danpeig/ESP32EnergyMonitor/images/home_assistant_integration.png

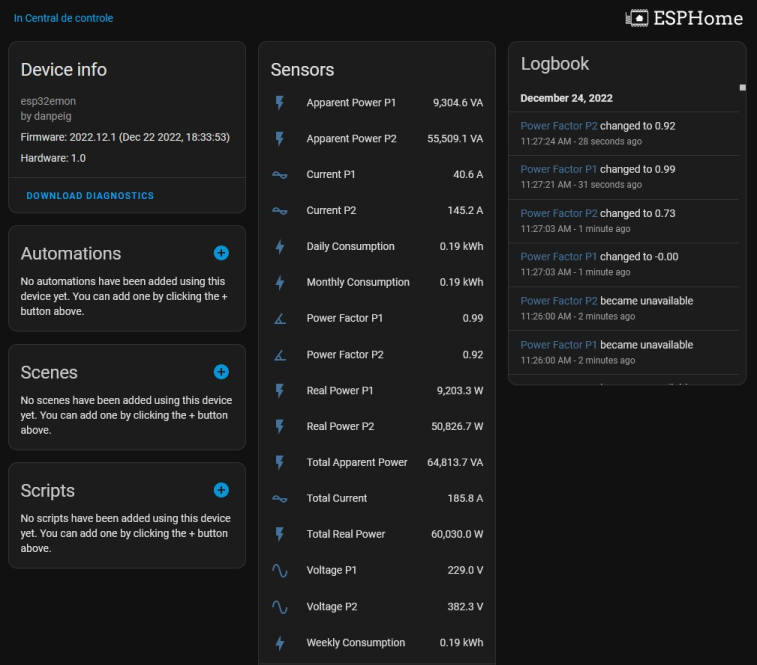
images/home_assistant_integration.png
