danpeig/ESP32EnergyMonitor/images/potenciometro-calibrado.jpg

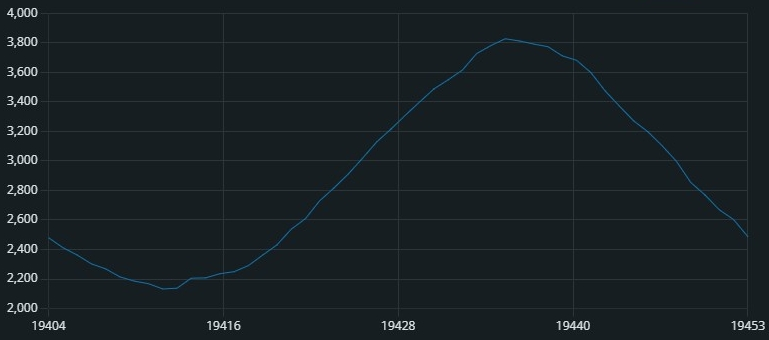
images/potenciometro-calibrado.jpg
