danpeig/ESP32EnergyMonitor/images/potenciometro-descalibrado.png

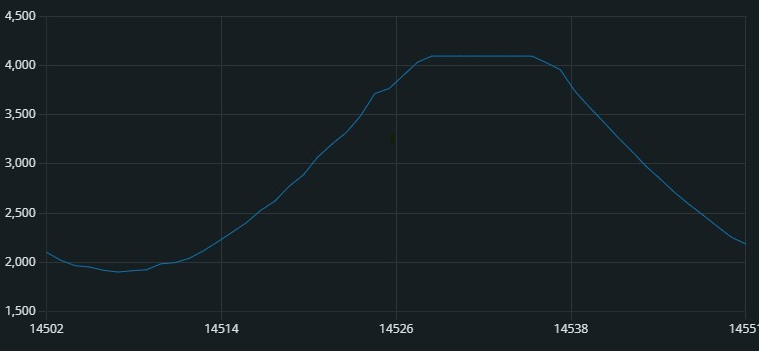
images/potenciometro-descalibrado.png
