danpeig/ESP32EnergyMonitor/(threads)

Thread 1 (2023-03-17):

Using without voltage meter?

fitim7, 2023-03-17:
Hi, is it possible to use this without a voltage meter?

danpeig, 2023-04-07:
ESPHome already has current measurements "out-of-the-box", there is no need to use this software at all (https://esphome.io/components/sensor/ct_clamp.html).

Please be aware that without voltage measurement you lose the ability to measure power factor and the real power.

Closed 2023-04-07.

Thread 2 (2023-03-19):

It will not read the third phase. Real Power and Power Factor

vladakru, 2023-03-19:
Greetings, I am very pleased with the project you made.
I have a problem with reading Power Factor P3 and Real Power P3 is always 0.00, P1 and P2 print values   normally.
I must mention that Apparent Power P3 and Current P3 also print values   normally.
I am afraid that this affects the Total Real Power so that the Monthly and Daily Consumption are incorrect.
How could I solve this problem?
THX
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

danpeig, 2023-03-19:
Hi,

Did you tried inverting the direction of the current sensor for P3?

vladakru, 2023-03-19:
I didn't turn the sensor because during the calibration process it was in the same direction as it is now and it worked like that, so I suspected that it might not be a problem in the code...

vladakru, 2023-03-19:
how does the Curen P3 measure me and it won't count the Real Power P3...???

danpeig, 2023-03-19:
Can you run the calibration script again replacing this code block:
`
  Serial.print("V3: ");
  Serial.print(supplyVoltage3);
  Serial.print(", I3: ");
  Serial.println(Irms3);
`

with this

`
  Serial.print("V3: ");
  Serial.print(supplyVoltage3);
  Serial.print("PF3: ");
  Serial.print(powerFactor3);
  Serial.print(", I3: ");
  Serial.println(Irms3);
`

What we are looking for is a negative power factor.

vladakru, 2023-03-19:
with no load:
------------
V1: 229.00, I1: 0.92
V2: 225.42, I2: 0.88
V3: 226.79PF3: -0.02, I3: 1.02

with load:
V1: 221.39, I1: 13.11
V2: 218.49, I2: 13.28
V3: 220.35PF3: 0.85, I3: 12.92

danpeig, 2023-03-19:
The hardware appears to be working well. 3 positive parameters.
Now we must check ESPHome and Home Assistant.
When you run the ESPHome console/terminal, do you get similar results in the output variables (voltage, current, and PF)?

vladakru, 2023-03-19:
This is report from pc terminal directly connected to ESP32
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

danpeig, 2023-03-19:
Ok, the problem is not in Home Assistant.

Would you mind sharing your _esp32emon.yaml_ and _esp32emon.h_ sources? You can change any sensitive information. I just want to compile and test here.

vladakru, 2023-03-20:
esp32emon.yaml
`# Platform settings
esphome:
  name: esp32emon
  name_add_mac_suffix: true
  includes:
    - emonlib/EmonLib.h
    - emonlib/EmonLib.cpp
    - esp32emon.h
  project:
    name: danpeig.esp32emon
    version: "1.3.0"

# Board configuration
esp32:
  board: esp32doit-devkit-v1
  framework:
    type: arduino

# Sets up Bluetooth LE (Only on ESP32) to allow the user
# to provision wifi credentials to the device.
esp32_improv:
  authorizer: none

# Sets up the improv via serial client for Wi-Fi provisioning
improv_serial:

# Enable logging
logger:

# Enable Home Assistant API
api:

# Enable OTA updates
ota:
  password: !secret ota_password

# Wifi configuration
wifi:
  networks:
    # Main network
   - ssid: !secret wifi_ssid
     password: !secret wifi_password
    # Alternative network
    # - ssid: !secret wifi_ssid2
      # password: !secret wifi_password2

  # Enable fallback hotspot (captive portal) in case wifi connection fails
  # ap:
    # ssid: "Esp32EnergyMeter"
    # password: !secret wifi_ap_password

captive_portal:

# MQTT Integration
#mqtt:
#  broker: !secret mqtt_broker
#  port: !secret mqtt_port
#  username: !secret mqtt_user
#  password: !secret mqtt_password
#  discovery: false #We are using the default API for Home Assistant discovery, no need for MQTT

# Timers configuration
time:
  - platform: sntp
    id: sntp_time1
    on_time:
      # Every Month at specified day
      - seconds: 0
        minutes: 0
        hours: 0
        days_of_month: 1
        then:
          - sensor.integration.reset: total_energy_month #Reset power integrator
      # Every Week at specified day
      - seconds: 0
        minutes: 0
        hours: 0
        days_of_week: MON
        then:
          - sensor.integration.reset: total_energy_week #Reset power integrator
      # Every Day at specified hour
      - seconds: 0
        minutes: 0
        hours: 0
        then:
          - sensor.integration.reset: total_energy_day #Reset power integrator

sensor:
  #Custom sensors from EMon
  - platform: custom
    lambda: |-
      auto my_sensor = new MyPowerSensor();
      App.register_component(my_sensor);

      // 1-Phase - - uncomment only the following line for 1 phase measurements
      //return {my_sensor->realpower_sensor1, my_sensor->apparentpower_sensor1, my_sensor->powerfactor_sensor1, my_sensor->supplyvoltage_sensor1, my_sensor->current_sensor1, my_sensor->realpower_sensor_total, my_sensor->apparentpower_sensor_total, my_sensor->current_sensor_total};

      // 2-Phases - uncomment only the following line for 2 phase measurements
      //return {my_sensor->realpower_sensor1, my_sensor->apparentpower_sensor1, my_sensor->powerfactor_sensor1, my_sensor->supplyvoltage_sensor1, my_sensor->current_sensor1, my_sensor->realpower_sensor2, my_sensor->apparentpower_sensor2, my_sensor->powerfactor_sensor2, my_sensor->supplyvoltage_sensor2, my_sensor->current_sensor2, my_sensor->realpower_sensor_total, my_sensor->apparentpower_sensor_total, my_sensor->current_sensor_total};

      // 3-Phases - uncomment only the following line for 3 phase measurements
      return {my_sensor->realpower_sensor1, my_sensor->apparentpower_sensor1, my_sensor->powerfactor_sensor1, my_sensor->supplyvoltage_sensor1, my_sensor->current_sensor1, my_sensor->realpower_sensor2, my_sensor->apparentpower_sensor2, my_sensor->powerfactor_sensor2, my_sensor->supplyvoltage_sensor2, my_sensor->current_sensor2, my_sensor->realpower_sensor3, my_sensor->apparentpower_sensor3, my_sensor->powerfactor_sensor3, my_sensor->supplyvoltage_sensor3, my_sensor->current_sensor3, my_sensor->realpower_sensor_total, my_sensor->apparentpower_sensor_total, my_sensor->current_sensor_total};
    sensors:
      #Phase 1 sensors
      - name: "Real Power P1"
        device_class: "power"
        unit_of_measurement: W
        state_class: "measurement"
        accuracy_decimals: 1
        internal: false
        filters:
          - lambda: |-
              //Avoid corrupting integration sensors
              if(!isinf(x) && !isnan(x) && x >= 0 && x <= 10e6)
                {
                return x;
                }
              else
                {
                return 0;
                }
      - name: "Apparent Power P1"
        device_class: "apparent_power"
        unit_of_measurement: VA
        state_class: "measurement"
        accuracy_decimals: 1
        internal: false
        filters:
          - lambda: |-
              //Avoid corrupting integration sensors
              if(!isinf(x) && !isnan(x) && x >= 0 && x <= 10e6)
                {
                return x;
                }
              else
                {
                return 0;
                }
      - name: "Power Factor P1"
        device_class: "power_factor"
        state_class: "measurement"
        accuracy_decimals: 2
        internal: false
        filters:
          - lambda: |-
              //Avoid corrupting integration sensors
              if(!isinf(x) && !isnan(x) && x >= 0 && x <= 10e6)
                {
                return x;
                }
              else
                {
                return 0;
                }
      - name: "Voltage P1"
        device_class: "voltage"
        unit_of_measurement: V
        accuracy_decimals: 1
        internal: false
        filters:
          - lambda: |-
              //Avoid corrupting integration sensors
              if(!isinf(x) && !isnan(x) && x >= 0 && x <= 10e6)
                {
                return x;
                }
              else
                {
                return 0;
                }
      - name: "Current P1"
        device_class: "current"
        unit_of_measurement: A
        accuracy_decimals: 1
        internal: false
        filters:
          - lambda: |-
              //Avoid corrupting integration sensors
              if(!isinf(x) && !isnan(x) && x >= 0 && x <= 10e6)
                {
                return x;
                }
              else
                {
                return 0;
                }

        #Phase 2 sensors
      - name: "Real Power P2"
        device_class: "power"
        unit_of_measurement: W
        state_class: "measurement"
        accuracy_decimals: 1
        internal: false
        filters:
          - lambda: |-
              //Avoid corrupting integration sensors
              if(!isinf(x) && !isnan(x) && x >= 0 && x <= 10e6)
                {
                return x;
                }
              else
                {
                return 0;
                }
      - name: "Apparent Power P2"
        device_class: "apparent_power"
        unit_of_measurement: VA
        state_class: "measurement"
        accuracy_decimals: 1
        internal: false
        filters:
          - lambda: |-
              //Avoid corrupting integration sensors
              if(!isinf(x) && !isnan(x) && x >= 0 && x <= 10e6)
                {
                return x;
                }
              else
                {
                return 0;
                }
      - name: "Power Factor P2"
        device_class: "power_factor"
        state_class: "measurement"
        accuracy_decimals: 2
        internal: false
        filters:
          - lambda: |-
              //Avoid corrupting integration sensors
              if(!isinf(x) && !isnan(x) && x >= 0 && x <= 10e6)
                {
                return x;
                }
              else
                {
                return 0;
                }
      - name: "Voltage P2"
        device_class: "voltage"
        unit_of_measurement: V
        accuracy_decimals: 1
        internal: false
        filters:
          - lambda: |-
              //Avoid corrupting integration sensors
              if(!isinf(x) && !isnan(x) && x >= 0 && x <= 10e6)
                {
                return x;
                }
              else
                {
                return 0;
                }
      - name: "Current P2"
        device_class: "current"
        unit_of_measurement: A
        accuracy_decimals: 1
        internal: false
        filters:
          - lambda: |-
              //Avoid corrupting integration sensors
              if(!isinf(x) && !isnan(x) && x >= 0 && x <= 10e6)
                {
                return x;
                }
              else
                {
                return 0;
                }

        #Phase 3 sensors
      - name: "Real Power P3"
        device_class: "power"
        unit_of_measurement: W
        state_class: "measurement"
        accuracy_decimals: 1
        internal: false
        filters:
          - lambda: |-
              //Avoid corrupting integration sensors
              if(!isinf(x) && !isnan(x) && x >= 0 && x <= 10e6)
                {
                return x;
                }
              else
                {
                return 0;
                }
      - name: "Apparent Power P3"
        device_class: "apparent_power"
        unit_of_measurement: VA
        state_class: "measurement"
        accuracy_decimals: 1
        internal: false
        filters:
          - lambda: |-
              //Avoid corrupting integration sensors
              if(!isinf(x) && !isnan(x) && x >= 0 && x <= 10e6)
                {
                return x;
                }
              else
                {
                return 0;
                }
      - name: "Power Factor P3"
        device_class: "power_factor"
        state_class: "measurement"
        accuracy_decimals: 2
        internal: false
        filters:
          - lambda: |-
              //Avoid corrupting integration sensors
              if(!isinf(x) && !isnan(x) && x >= 0 && x <= 10e6)
                {
                return x;
                }
              else
                {
                return 0;
                }
      - name: "Voltage P3"
        device_class: "voltage"
        unit_of_measurement: V
        accuracy_decimals: 1
        internal: false
        filters:
          - lambda: |-
              //Avoid corrupting integration sensors
              if(!isinf(x) && !isnan(x) && x >= 0 && x <= 10e6)
                {
                return x;
                }
              else
                {
                return 0;
                }
      - name: "Current P3"
        device_class: "current"
        unit_of_measurement: A
        accuracy_decimals: 1
        internal: false
        filters:
          - lambda: |-
              //Avoid corrupting integration sensors
              if(!isinf(x) && !isnan(x) && x >= 0 && x <= 10e6)
                {
                return x;
                }
              else
                {
                return 0;
                }

      #Total sensors
      - name: "Total Real Power"
        id: "real_power_sensor_total"
        device_class: "power"
        state_class: "measurement"
        unit_of_measurement: W
        accuracy_decimals: 1
        internal: false
        filters:
          - lambda: |-
              //Avoid corrupting integration sensors
              if(!isinf(x) && !isnan(x) && x >= 0 && x <= 10e6)
                {
                return x;
                }
              else
                {
                return 0;
                }
      - name: "Total Apparent Power"
        device_class: "apparent_power"
        state_class: "measurement"
        unit_of_measurement: VA
        accuracy_decimals: 1
        internal: false
        filters:
          - lambda: |-
              //Avoid corrupting integration sensors
              if(!isinf(x) && !isnan(x) && x >= 0 && x <= 10e6)
                {
                return x;
                }
              else
                {
                return 0;
                }
      - name: "Total Current"
        device_class: "current"
        state_class: "measurement"
        unit_of_measurement: A
        accuracy_decimals: 1
        internal: false
        filters:
          - lambda: |-
              //Avoid corrupting integration sensors
              if(!isinf(x) && !isnan(x) && x >= 0 && x <= 10e6)
                {
                return x;
                }
              else
                {
                return 0;
                }

  - platform: integration
    name: "Daily Consumption"
    id: "total_energy_day"
    sensor: real_power_sensor_total
    time_unit: h
    device_class: "energy"
    state_class: "total_increasing"
    unit_of_measurement: kWh
    accuracy_decimals: 2
    restore: false #If true, save the reading to the flash memory to prevent data loss in case of power loss
    filters:
      - multiply: 0.001

  - platform: integration
    name: "Weekly Consumption"
    id: "total_energy_week"
    sensor: real_power_sensor_total
    time_unit: h
    device_class: "energy"
    state_class: "total_increasing"
    unit_of_measurement: kWh
    accuracy_decimals: 2
    restore: false #If true, save the reading to the flash memory to prevent data loss in case of power loss
    filters:
      - multiply: 0.001

  - platform: integration
    name: "Monthly Consumption"
    id: "total_energy_month"
    sensor: real_power_sensor_total
    time_unit: h
    device_class: "energy"
    state_class: "total_increasing"
    unit_of_measurement: kWh
    accuracy_decimals: 2
    restore: false #If true, save the reading to the flash memory to prevent data loss in case of power loss
    filters:
      - multiply: 0.001

  # Wifi signal sensors
  - platform: wifi_signal # Reports the WiFi signal strength/RSSI in dB
    name: "WiFi signal dB"
    id: wifi_signal_db
    update_interval: 60s
    entity_category: "diagnostic"

  - platform: copy # Reports the WiFi signal strength in %
    source_id: wifi_signal_db
    name: "WiFi signal"
    filters:
      - lambda: return min(max(2 * (x + 100.0), 0.0), 100.0);
    unit_of_measurement: "%"
    entity_category: "diagnostic"

# Other information
text_sensor:
  - platform: wifi_info
    ip_address:
      name: ESP32 IP Address
    ssid:
      name: ESP32 SSID`

esp32emon.h
`#include "esphome.h"
#include "EmonLib.h"
#include "esp_task_wdt.h" //Watchdog control features
#define ESP32

// Watchdog timeout in seconds
#define WDT_TIMEOUT 5

// The Sample window length is defined by the number of half wavelengths or crossings we choose to measure.
// 120 is quite conservative for two phases
#define CROSSINGS 120

// Polling interval
#define POLLING_INTERVAL 30000 //Every 30s will perform a read and publish the data. Do not go under 5s to prevent crashes.

// Pin configuration
#define V1 34
#define V2 34 //Set to V1 if using only one voltage meter
#define V3 34 //Set to V1 if using only one voltage meter

#define I1 35
#define I2 32
#define I3 33

// Calibration for voltage sensors CV and current sensors CI
#define CV1 350.31
#define CV2 346.5 //Set to CV1 if using only one voltage meter
#define CV3 347.23 //Set to CV1 if using only one voltage meter

#define CI1 64.92
#define CI2 65.65
#define CI3 64.41

class MyPowerSensor : public PollingComponent, public Sensor
{
public:
  MyPowerSensor() : PollingComponent(POLLING_INTERVAL) {}

  float get_setup_priority() const override { return esphome::setup_priority::LATE; }

  EnergyMonitor emon1; // Phase 1
  EnergyMonitor emon2; // Phase 2
  EnergyMonitor emon3; // Phase 3

  // Phase 1 sensors
  Sensor *realpower_sensor1 = new Sensor();
  Sensor *apparentpower_sensor1 = new Sensor();
  Sensor *powerfactor_sensor1 = new Sensor();
  Sensor *supplyvoltage_sensor1 = new Sensor();
  Sensor *current_sensor1 = new Sensor();

  // Phase 2 sensors
  Sensor *realpower_sensor2 = new Sensor();
  Sensor *apparentpower_sensor2 = new Sensor();
  Sensor *powerfactor_sensor2 = new Sensor();
  Sensor *supplyvoltage_sensor2 = new Sensor();
  Sensor *current_sensor2 = new Sensor();

  // Phase 3 sensors
   Sensor *realpower_sensor3 = new Sensor();
   Sensor *apparentpower_sensor3 = new Sensor();
   Sensor *powerfactor_sensor3 = new Sensor();
   Sensor *supplyvoltage_sensor3 = new Sensor();
   Sensor *current_sensor3 = new Sensor();

  // Total sensors
  Sensor *realpower_sensor_total = new Sensor();
  Sensor *apparentpower_sensor_total = new Sensor();
  Sensor *current_sensor_total = new Sensor();

  void setup() override
  {

    esp_task_wdt_init(WDT_TIMEOUT, true); // enable panic so ESP32 restarts
    esp_task_wdt_add(NULL);               // add current thread to WDT watch

    /*
    Analog attenuation: When using 0-1V sensors the attenuation should be decreased to improve accuracy.

    ADC_0db: sets no attenuation. ADC can measure up to approximately 800 mV (1V input = ADC reading of 1088).
    ADC_2_5db: The input voltage of ADC will be attenuated, extending the range of measurement to up to approx. 1100 mV. (1V input = ADC reading of 3722).
    ADC_6db: The input voltage of ADC will be attenuated, extending the range of measurement to up to approx. 1350 mV. (1V input = ADC reading of 3033).
    ADC_11db (default): The input voltage of ADC will be attenuated, extending the range of measurement to up to approx. 2600 mV. (1V input = ADC reading of 1575).

    */
    analogSetPinAttenuation(V1, ADC_11db);
    analogSetPinAttenuation(V2, ADC_11db);
    analogSetPinAttenuation(V3, ADC_11db);

    analogSetPinAttenuation(I1, ADC_11db);
    analogSetPinAttenuation(I2, ADC_11db);
    analogSetPinAttenuation(I3, ADC_11db);

    // Phase 1 sensors
    emon1.voltage(V1, CV1, 1.732); // Voltage: input pin, calibration, phase_shift
    emon1.current(I1, CI1);        // Current: input pin, calibration.

    // Phase 2 sensors
    emon2.voltage(V2, CV2, 1.732); // Voltage: input pin, calibration, phase_shift
    emon2.current(I2, CI2);        // Current: input pin, calibration.

    //Phase 3 sensors
    emon3.voltage(V3, CV3, 1.732);  // Voltage: input pin, calibration, phase_shift
    emon3.current(I3, CI3);       // Current: input pin, calibration.

  }

  void update() override
  {

    // Phase 1
    emon1.calcVI(CROSSINGS, 2000);
    float realPower1 = emon1.realPower;
    realpower_sensor1->publish_state(realPower1);
    float apparentPower1 = emon1.apparentPower;
    apparentpower_sensor1->publish_state(apparentPower1);
    float powerFactor1 = emon1.powerFactor;
    powerfactor_sensor1->publish_state(powerFactor1);
    float supplyVoltage1 = emon1.Vrms;
    supplyvoltage_sensor1->publish_state(supplyVoltage1);
    float current1 = emon1.Irms;
    current_sensor1->publish_state(current1);

    esp_task_wdt_reset(); // Things can take some time... this ensures the watchdog is aware

    // Phase 2
    emon2.calcVI(CROSSINGS, 2000);
    float realPower2 = emon2.realPower;
    realpower_sensor2->publish_state(realPower2);
    float apparentPower2 = emon2.apparentPower;
    apparentpower_sensor2->publish_state(apparentPower2);
    float powerFactor2 = emon2.powerFactor;
    powerfactor_sensor2->publish_state(powerFactor2);
    float supplyVoltage2 = emon2.Vrms;
    supplyvoltage_sensor2->publish_state(supplyVoltage2);
    float current2 = emon2.Irms;
    current_sensor2->publish_state(current2);

    esp_task_wdt_reset(); // Things can take some time... this ensures the watchdog is aware

     // Phase 3
     emon3.calcVI(CROSSINGS,2000);
     float realPower3 = emon3.realPower;
     realpower_sensor3->publish_state(realPower3);
     float apparentPower3 = emon3.apparentPower;
     apparentpower_sensor3->publish_state(apparentPower3);
     float powerFactor3 = emon3.powerFactor;
     powerfactor_sensor3->publish_state(powerFactor3);
     float supplyVoltage3 = emon3.Vrms;
     supplyvoltage_sensor3->publish_state(supplyVoltage3);
     float current3 = emon3.Irms;
     current_sensor3->publish_state(current3);

    /*
    // Totals 1 phase - uncomment only this block if you are reading one phase
    float realPower_total = emon1.realPower;
    realpower_sensor_total->publish_state(realPower_total);
    float apparentPower_total = emon1.apparentPower;
    apparentpower_sensor_total->publish_state(apparentPower_total);
    float current_total = emon1.Irms;
    current_sensor_total->publish_state(current_total);
    */

	/*
    // Totals 2 phases - uncomment only this block if you are reading two phases
    float realPower_total = emon1.realPower + emon2.realPower;
    realpower_sensor_total->publish_state(realPower_total);
    float apparentPower_total = emon1.apparentPower + emon2.apparentPower;
    apparentpower_sensor_total->publish_state(apparentPower_total);
    float current_total = emon1.Irms + emon2.Irms;
    current_sensor_total->publish_state(current_total);
	*/

     // Totals 3 phases - uncomment only this block if you are reading three phases
     float realPower_total = emon1.realPower + emon2.realPower + emon3.realPower;
     realpower_sensor_total->publish_state(realPower_total);
     float apparentPower_total = emon1.apparentPower + emon2.apparentPower + emon3.apparentPower;
     apparentpower_sensor_total->publish_state(apparentPower_total);
     float current_total = emon1.Irms + emon2.Irms + emon3.Irms;
     current_sensor_total->publish_state(current_total);

  }
};
`

vladakru, 2023-03-20:
thanks for your time, I'll try flashing again and see if it works.
thanks again

vladakru, 2023-03-20:
As you saw on the test table, everything worked as it should, when I connected it to the mains, one phase read amperes again, but not PF and RP, when I turned the CT sensor in the opposite direction, that phase worked with the readings. I don't know how it's like the current is flowing in the opposite direction or whatever... I hope that now with that setup the reading will be fine.

danpeig, 2023-03-26:
Here is the explanation from OpenEnergyMonitor:

Does the direction the CT is clipped on the wire, matter?

If you are interested in reading only apparent power, and you don’t have an AC-AC adapter, it does not matter. The power reading will always be positive.

If you want to read real power, and you want to know in which direction power is flowing – e.g. when you generate your own electricity, and want to know whether you are importing or exporting – then the C.T. must face the correct direction. Our convention is: imported and generated powers are positive. If the C.T. faces the wrong way, it means that the power you expect to be positive will be shown as negative. [Note: Robin Emley has adopted the opposite convention for his Mk 2 energy diverter – he regards exported power as positive.]

For the UK ac-ac adapter and the YHDC C.T. purchased from the shop and when the C.T. is on the line conductor, the printing on the face of the C.T. should face in the direction of positive power, i.e. in the picture above, positive power flow is from left to right. If the C.T. is on the neutral conductor (this is only valid on a single-phase installation) it should face in the opposite direction. For any other combination of ac-ac adapter and C.T. it is possible, if the phasing of each is known, to determine the correct orientation, but the easiest and quickest method is probably by trial and error. Reversing the C.T. will change the sign of that input. Reversing the ac-ac adapter (where the plug design allows this) will change the sign of all inputs.

Closed 2023-03-26.

Thread 3 (2023-03-25):

Illogical calculation.!?

vladakru, 2023-03-25:
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
what bothers me is that the total current is 4.7A and the total real power is only 362w. is that formula for calculating power a bit messy, I think that with 4A current the real power should be at least 1000w.
the code has not been modified, it is original as you wrote it.

danpeig, 2023-03-26:
Real power takes into consideration the power factor. This is what is impacting your calculation.

danpeig, 2023-03-26:
Try inverting the direction of the CT clamps.

Closed 2023-04-07.

Thread 4 (2023-04-07):

Not LOGS

juanpablo132, 2023-04-07:
Hi! I have this problem I trying to LOGS!

_INFO Reading configuration /config/esphome/esp32emon.yaml...
INFO Detected timezone 'America/Argentina/Buenos_Aires'
INFO Starting log output from esp32emon.local using esphome API
WARNING Can't connect to ESPHome API for esp32emon.local: Error connecting to ('192.168.3.131', 6053): [Errno 111] Connect call failed ('192.168.3.131', 6053)
INFO Trying to reconnect to esp32emon.local in the background_

danpeig, 2023-04-07:
Double check the ESP32 Wifi settings and flash the firmware again using the USB cable.

danpeig, 2023-04-07:
This is not a ESP32EnergyMonitor issue.

Closed 2023-04-07.

Thread 5 (2023-04-13):

Is the offset of 2.5V not an issue

paulca99, 2023-04-13:
Hi Dan , Great readme, I'm about to build this, I've been running on an arduino mega for years. I was just wondering if you'd tried using 3.3V as the Vcc onto the zmpt101b to get the voltage centred correctly around 1.666V , or doesn't it really matter ? it seems to use an LM358 which has a min Vcc of 3V so it might work even though the datasheet for the zmpt101b says 5-30V . Just seems a shame to lose such a big chunk of the ADC resolution.

danpeig, 2023-04-14:
During my research I found that the module would provide more consistent results if using 5V supply and found that it worked well. Never tried the 3.3V option.

https://surtrtech.com/2020/04/08/measure-any-ac-voltage-250vac-with-zmpt101b-and-esp8266-12e-with-android-app-adafruit-io-mqtt/

paulca99, 2023-04-14:
Interesting, he's using 3.3V in that example and it seems to work ok.  It's a bit confusing as the write up says "the signal will be lost at some points using 3.3V"  but I think he's just talking about the clipping , which can be cancelled out with the pot. I'll try both.

danpeig, 2023-04-14:
This user proposed an interesting solution but requires hardware modifications: https://github.com/a-boudersa/ZMPT101B-3.3V-ADC

Closed 2023-12-24.

Thread 6 (2023-04-22):

ESP8266

borodihin, 2023-04-22:
Good day, Daniel!
Can I use this code with 8266 module (such as Node MCU or Wemos module)?

danpeig, 2023-04-22:
Yes. You will need to change the MCU type in the configuration file and select the instrument to be used as it only has 1 ADC pin.

Closed 2023-12-24.

Thread 7 (2023-07-18):

Warning "ADC_BITS"

wanball, 2023-07-18:
I encountered this problem. I don't know if there is a solution or not.
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

danpeig, 2023-07-18:
This happens because I wanted to keep the original Emon library that was initially written for the ESP8266. The ADC resolution was updated just by declaring the constant again, thus the warning.

It will not affect the program execution.

Closed 2023-07-18.

Thread 8 (2023-09-17):

Use only voltaje meter?

carferrer, 2023-09-17:
Hello, first, great work!!

Is possible to use only voltaje meter, no current? I have 3 phases.

Thanks.

danpeig, 2023-09-17:
Yes. You can measure only voltage. Just use a value of zero as calibration for the current to prevent random reports of power.

________________________________
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

carferrer, 2023-09-17:
> Yes. You can measure only voltage. Just use a value of zero as calibration for the current to prevent random reports of power.
> […](#)
> ________________________________ From: carferrer ***@***.***> Sent: Sunday, 17 September 2023 14:20 To: danpeig/ESP32EnergyMonitor Cc: Subscribed Subject: [danpeig/ESP32EnergyMonitor] Use only voltaje meter? (Issue #8) Hello, first, great work!! Is possible to use only voltaje meter, no current? I have 3 phases. Thanks. — Reply to this email directly, view it on GitHub<#8>, or unsubscribe<https://github.com/notifications/unsubscribe-auth/AB63V32LLBD7H6GIZBVLTVTX24WMTANCNFSM6AAAAAA43XXESY>. You are receiving this because you are subscribed to this thread.Message ID: ***@***.***>

Thanks!!

Closed 2023-12-24.

Thread 10 (2023-12-24):

I want to use ACS712

Dydipanshu, 2023-12-24:
Hey, First of all very great work .....thanks for this.

But I wanted to ask you if it is possible to make this using ACS712 current sensor. If yes,then can you please tell me what connections should i make as I am having a hard time in figuring it out as it has completely different pins and input then the one used by you.

danpeig, 2023-12-24:
Hi,

The ACS712 as far as I know is rated for 5V. If you can find one that works with 3V, you can connect VOut to the current sensing GPIO and use the code as it is.

Dydipanshu, 2023-12-26:
Is there a way I can use voltage divider circuit.....if yes can you please provide me with a cirucit diagram where everything is connected as your current circuit diagram is confusing to me.

Everything connected means
ESP32,ZMPT101B,ACS712,Voltage divider circuit,Supply,Load

I will be very thankful to you as I have been trying to find and do it for the past 15 days but nothing seems to be working.

danpeig, 2023-12-28:
Hi,

I don't have experience with the ACS712 neither have some of that modules laying around to play with.

My advice is use an oscilloscope to ensure your physical circuit is fine and only then move to the ESP. The ADC of ESP32 is not that simple to work with.

Closed 2023-12-24.

Thread 11 (2024-01-22):

PJ-307 pinout

Caddyman68, 2024-01-22:
Remember - there are no stupid questions. Mine is "where do I connect a)GPIO35 and b)the convergence of the 2 main resistors+ the positive side of the capacitor?" I understand that GPIO35 connects to "tip" and the other side to "sleeve" and I know what that is (I think) on the SCT013, but which of the 5 tabs on the PJ-307 are they? The pinouts I've seen - Ali Express for example - number them 1 (looks like sleeve) then 5-4 (normally closed) and 3-2 (normally closed). With plug inserted, I would think tip would be 5 (or 2) since it would disconnect from 4 (or 3)
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

I have tried different combinations with no luck; possibly have messed everything up already. I tested the voltage divider circuit with a multimeter and it seems okay. I am only using the basic ESPHome configuration for CT clamp - I notice you referenced this in issue #1 "Using without voltage meter". I have the ZMPT101B but wanted to see if I can get the CT clamp to work first. Also, I have the 0-1V output sensor so I don't have the burden resistor in the schematic. I have tried each of the 2 SCT013s I got from Ali; I can't test with a multimeter because the AC voltage range is too high (200VAC) but I seem to get voltage between all 3 contacts (tip/ring/sleeve).
The picture of your wiring looks like
Thanks in advance for your help and indulgence. I appreciate the time you took to share your project with the community

Rhys79, 2024-02-20:
Pin 5 is Tip, Pin 2 is Ring, Pin 1 is Sleeve (TRS = Tip Ring Sleeve).  Pin 3 & 4 are used by more advanced equipment to determine: A - if there is a plug currently inserted into the jack (continuity broken between 2/3 & 4/5) and B - if the inserted plug is a TS (Tip/Sleeve aka Mono), or TRS (Tip/Ring/Sleeve aka Stereo).  Add an addition contact/breaker pair and you get a TRRS (Tip/Ring1/Ring2/Sleeve) jack, typically used by headsets, the additional Ring terminal used for the mono microphone input with ground common between mic and speakers.

Caddyman68, 2024-02-22:
> [Rhys79](/Rhys79)

Thanks for the help. I took one of the jacks apart but it's molded plastic (and pretty tiny) so it fell apart mostly. I could tell the tip was pin 5 and ring (middle section) looked like it should be 2, but it didn't seem like the last section (sleeve) was making contact with pin 1. Again, by this time it had fallen apart. The use of only pin 1 and 5 makes sense of the photo in the article - I only see a wire and a resistor and it almost looked like they were wired at the same point. Of course now I see that the wire goes through the board and connects to pin 1 while it is more apparent that the resistor goes to pin 5 at the bottom which also answers my question (not asked) about whether or not the pinout drawing of the PJ-307 was from the top - which it is.
 I connected pin 5 to GPIO35 - didn't use a burden resistor since my SCT013 is the voltage variety. I connected pin 1 to the voltage divider (point where the 2 resistors meet the capacitor). I have yet to test - I repaired the wiring on the heater I used so need to get some ambition to "strip" it again.
I guess a big part of my confusion involved NOT connecting the ring. As a side story, I used to work on telephone lines where tip & ring were the norm and ground - basically sleeve - was bad LOL. Not sure I even connected pin 1 in any of my trials.
Thanks again for your detailed explanation. I could tell that inserting a jack would break continuity between 2 - 3 and 4 - 5, but couldn't comprehend how that would be useful (ie why you would even need 3 and 4). Hopefully I'll get ambitious tomorrow and test. I will wait a few days and update before closing the issue even though my question is answered now

Rhys79, 2024-05-10:
Sorry for the long delay, things have been "eventful" in my personal life as of late.

Glad I was able to help!  My father was an EE, and I've been in IT for decades and have been playing with IOT designs since before IOT was a thing, but never as more than a hobby.  I remember how difficult it was at first learning how to read datasheets and understand diagrams, so I'm always happy to answer a question here and there to help makes things easier for newcomers than I had it.  I'm glad you found my explanation both helpful and easy to understand.  Feel free to ping me if you ever run into a similar question and need help :)

Caddyman68, 2024-05-10:
Thanks again for the reply. To be honest, I completely forgot about the question and to close the issue. I tested and it didn't work - no doubt something I did wrong other than the jack (soldering maybe since the PJ-307 won't just sit on a breadboard). I had intended to just cut the cord and hard wire it, but in the interim I ordered a completed project (Energy meter) from Ali that actually came without the plug/jack combo. The stripped wires (red & black) wire to a Zigbee device that looks similar to a Sonoff mini which interfaced easily with Home Assistant. I lost interest or I'd have stripped the SCT013 and tried it with the new device just to see if it was defective (or I broke it).
We are indeed luckier today than just a few years ago that there is a forum to share knowledge/information and people like you willing to help. Thanks again - this time I will close the issue.

Closed 2024-05-10.

Thread 12 (2024-03-08):

Calibration of SCT013 current sensor

zamojski, 2024-03-08:
The calibration program is supposed to calculate `CI1` etc. values. But what are these factors in real world? Is it a power factor of calibrated load?

zamojski, 2024-03-22:
I've troubles adapting this code to work on Kincony M16v2 where I've fully calibrated SCT013 sensor but only apparent power calculations. On the below screenshot the voltage reading is accurate (~0.2V error). I've calibrated `CI1` but I don't know if this approach will work for for varying current (like standby using 5W and PF 90 and turned on 35W PF 45).

Nonetheless power factor doesn't seem to be right. @danpeig Can you please advise?
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

zamojski, 2024-03-22:
Here on pure resistive load when turned on:
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
and when load is unplugged:
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

danpeig, 2024-11-20:
What is the range of your SCT probe? 33W is too low, probably below the sensor range.

zamojski, 2024-11-20:
10A - the smallest I could buy.

Thread 13 (2024-11-20):

Real power  phase 3

iankds05, 2024-11-20:
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

I wonder if you could shed any light as to why the only value I don't seem to be getting is the Real power calculation on P3
My set up has all the settings arranged to monitor 3 phases as per your write up and everything seems to conform to the correct values after calibration of voltages and actual current measured with calibrated digital meter.
I have gone through the code files both for emonlib and the yaml but nothing jumps out as being corrupted or incorrect formation and compilation in ESPHome works fine. I have swapped out the CT's and tested all connections but still no output for P3 kW. I only use one voltage measurement  input for all 3 phases. Any suggestions would be appreciated

iankds05, 2024-11-20:
Yep that's because p3 is dedicated to the thermal water heater which is controlled by thermostat. When its on, gives a current reading of 7.3A but real power is still not calculated. I'll try to capture a photo grab when its on to show

danpeig, 2024-11-20:
Did you tried to invert the current sensor in the wire?

iankds05, 2024-11-20:
Yes and swap it out for a brand new one as well

iankds05, 2024-11-20:
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

This is the issue with current and voltage being obtained but no Real Power Calculation

iankds05, 2024-11-20:
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

Everything else works just perfect apart from the calculations on P3 phase

danpeig, 2024-11-20:
What output do you get from CalculeteVI sketch for sensor 3?

iankds05, 2024-11-20:
When I did the calibration before installing I used a room heater drawing 1.5A for all three CT's and they were all withing 1% tolerance using the following cal settings. CT's are 100A 50ma open clamp type
#define CV1 470
#define CV2 470
#define CV3 470

#define CI1 41
#define CI2 42
#define CI3 42

The real current readings for P1 and P2 are acceptable tolerance measured with DM

iankds05, 2024-11-20:
Ok thanks for that info  I'll check that and get back to you.

iankds05, 2024-11-21:
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

So took you advice and added the "-" to code and it appears to have worked. No idea what the anomaly is with that phase but for now it working fine. Thanks for you input, I doubt I'd have figured out the fix

danpeig, 2024-11-21:
Great! When I have time I will review the code to use the absolute values instead of zero outputs. The power factor is correct? It should be close to 1 for resistive loads.

marcinnap76, 2024-11-22:
> ![Murray_Energy](https://private-user-images.githubusercontent.com/11013066/388731023-96cd3a2e-be6e-4a8a-af92-31acc616518a.jpg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)
>
> So took you advice and added the "-" to code and it appears to have worked. No idea what the anomaly is with that phase but for now its working fine. Thanks for your input, I doubt I'd have figured out the fix

I would also try instead of negative ‚-‚ switching the sides of the cable of clamps. That helped me. Before it was showing zero. Now it works correctly

Closed 2024-11-22.

Thread 14 (2024-12-08):

Calibrating the ZMPT101B, sharp peaks and troughs

timomer, 2024-12-08:
Hello,

I have setup the hardware and uploaded the code for Calibrating the ZMPT101B, but my charts are appearing as follows:
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

This is very different from the example shown, where the peaks and troughs are more spread out. Before I proceed to the next step, can I confirm that what I am seeing is correct, or have I made a mistake somewhere?

Note I have not connected any of the Current Transformers yet (3 phase)

mackloo, 2025-01-29:
I am trying this myself, mine did almost have the same look to it as in the readme but it was way faster and I did not really notice any difference when I turned the pot, I left it at good enough.

Can't give you any advice though.
You should tripple check that you have connected the correct pins I guess or try another pin to see if the first one is faulty.

Have you gotten further ahead? Im trying to calibrate my CT clamps but they seem to pick up noise because i'm reading around 5 amps with no load and even without the probes connected.. Do you have similar issues? I've read that the ADC pins on ESP32 boards are noisy but this seems ridiculous..

I've tried two different boards, it has gotten better, now i'm down to 12v reading from 77v but CT clamps is still around 5A.

timomer, 2025-01-30:
Hi, thanks for your feedback. I needed to get my project live for the start of this year so ended up buying a shelly 3em so I could just get it live.
I'm currently renovating my work space but once done will pick this up as I have another project I will use it for. Hope to do so in a month and will report back

Thread 15 (2025-02-06):

CTs output 1V and ADS1115

Rikyps, 2025-02-06:
Hi,
I'm trying to use the code which seems great to me but I'm running into a problem, I need to measure 10 channels (although that doesn't worry me).
The problem is that my CTs are 50A/1V so I want to use an ADS1115 (as many as necessary) in differential mode A0_A1, A2_A3, etc.
How can I do this? I calibrate the voltage but I can't calibrate the current.
Thank you very much

danpeig, 2025-02-07:
Hi, I don't have familiarity with this multiplexer.
