danpeig/ESP32EnergyMonitor/(commit log)

2022-12-31 Updated Power Factor state class
    To prevent log pollution.
2023-01-10 Filters everywhere + readme
    Added filters to all sensors to prevent integrator and Home Assistant DB corruption.
2023-03-26 CT clamp direction notes
2023-03-26 Current sensor direction comments
2023-04-02 Version 1.4
    Updated wifi signal device class
2023-04-13 Updated diagram
    Indication of extra pins for voltage meters.
2023-04-13 Delete ESP32-Energy-Monitor-Diagram.svg
    Obsolete
2023-04-13 Delete ESP32-Energy-Monitor.png
    Obsolete file
2023-04-13 Updated diagram
    Included extra voltage meter pins
2023-06-16 Reboot button
2025-11-07 wdt_update
    Updated watchdog timeout from seconds to milliseconds and added configuration for FreeRTOS core settings.
